ImSimao/FE-AGSG-S2026/schemes/README.md

Electromechanical diagrams
====

This directory contains the electrical schematic diagrams of the vehicle's electromechanical components.

## Files

- `communication_diagram.png` — data and communication links between the controllers, sensors and actuators (UART, I2C, PWM, GPIO).
- `power_diagram.png` — power distribution (battery, regulators, motor, servo, controllers and sensors).
