ImSimao/FE-AGSG-S2026/ui/arena.png

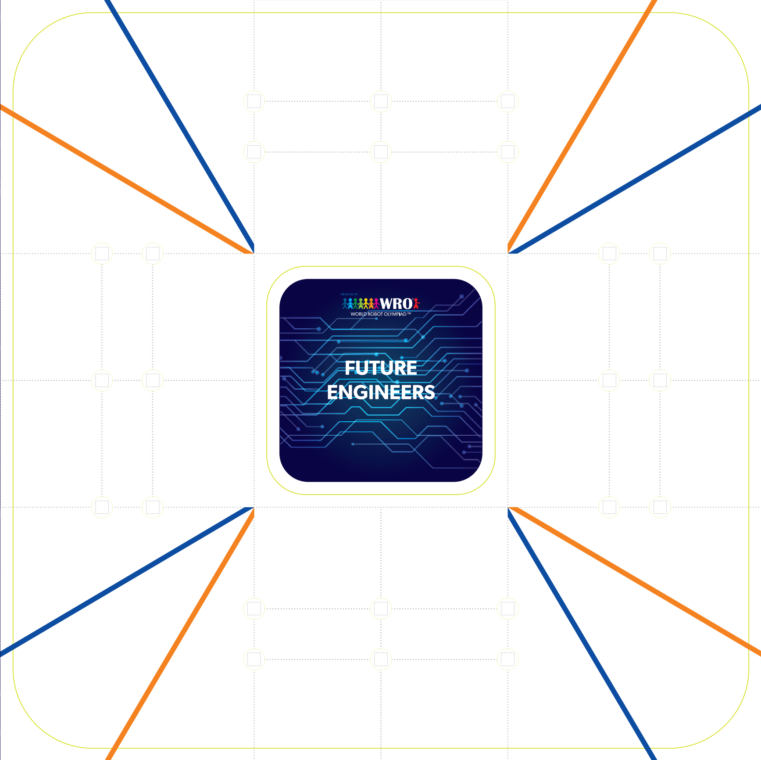
ui/arena.png
