ImSimao/FE-AGSG-S2026/models/Front Bearing.step

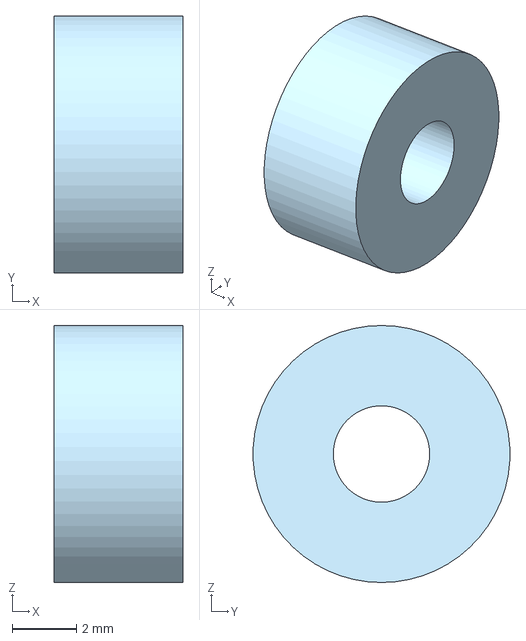
[picture p10: CAD file, 2026-11-11]
models/Front Bearing.step
4.00 x 7.99 x 8.00 mm
