ImSimao/FE-AGSG-S2026/models/Sonar Support.step

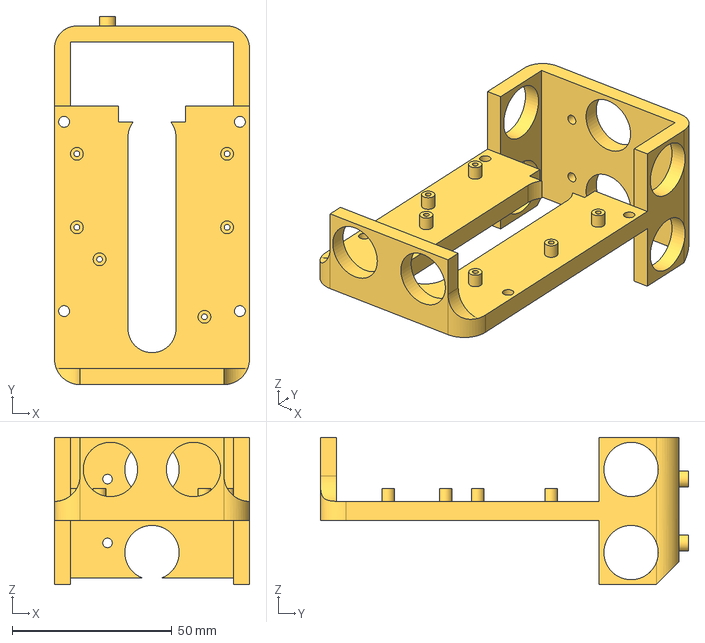
[picture p11: CAD file, 2026-11-11]
models/Sonar Support.step
61.0 x 115.2 x 46.0 mm
