ImSimao/FE-AGSG-S2026/models/Arm v1.step

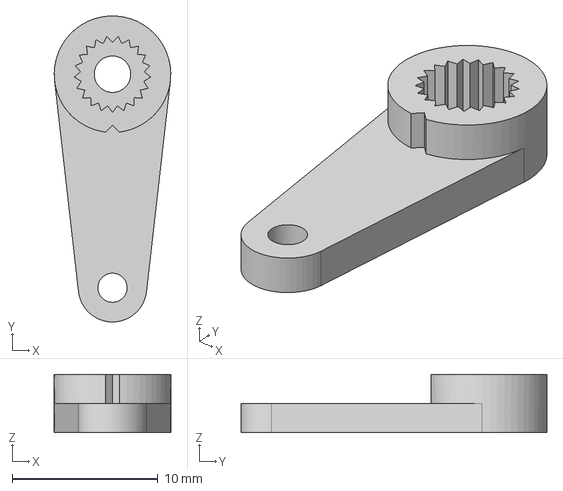
[picture p12: CAD file, 2026-11-11]
models/Arm v1.step
8.00 x 21.0 x 4.00 mm
