ImSimao/FE-AGSG-S2026/models/Wheel Front-Right.step

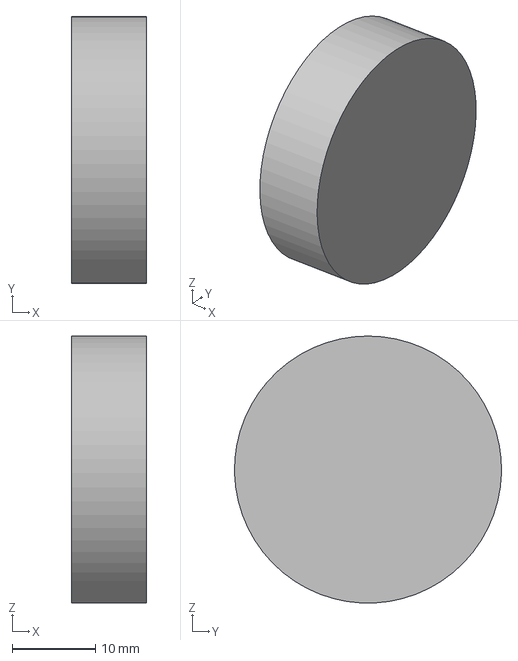
[picture p13: CAD file, 2026-11-11]
models/Wheel Front-Right.step
9.00 x 32.0 x 32.0 mm
