ImSimao/FE-AGSG-S2026/models/Axle Sleeve.step

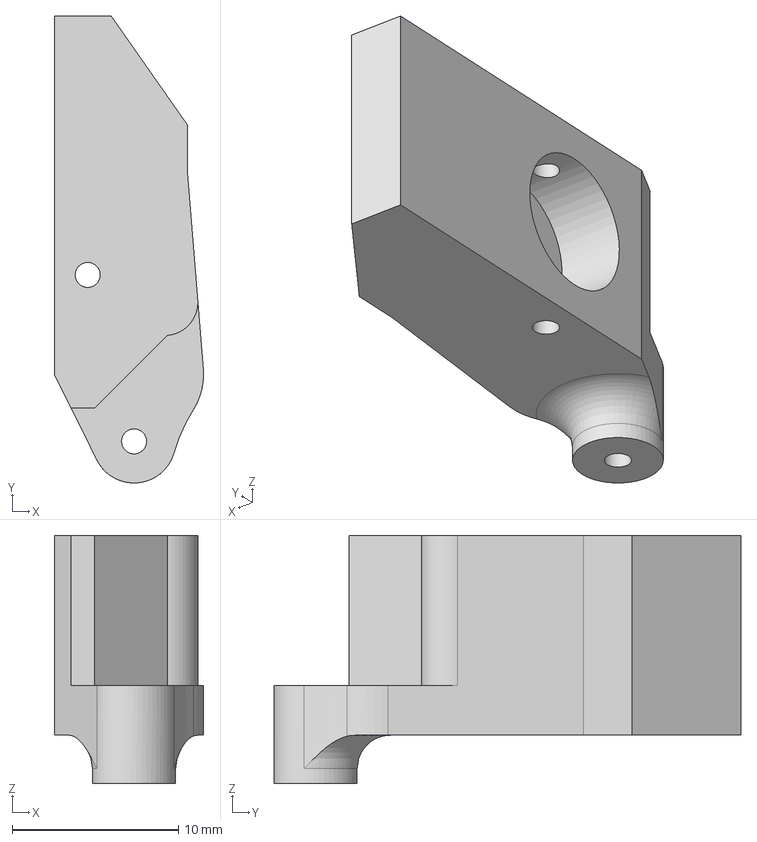
[picture p14: CAD file, 2026-11-11]
models/Axle Sleeve.step
8.96 x 28.1 x 14.9 mm
