ImSimao/FE-AGSG-S2026/models/Servo Support.step

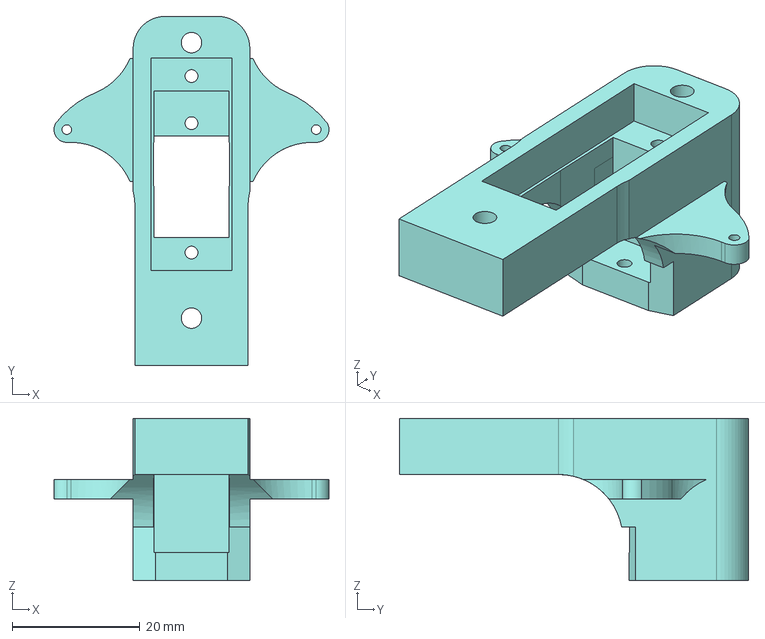
[picture p15: CAD file, 2026-11-11]
models/Servo Support.step
43.0 x 54.6 x 25.4 mm
