ImSimao/FE-AGSG-S2026/models/Gear Housing.step

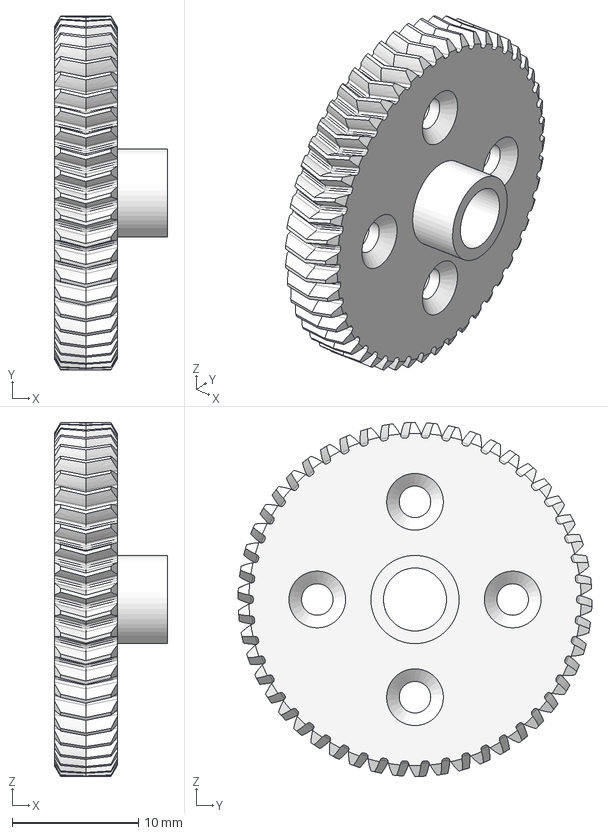
[picture p16: CAD file, 2026-11-11]
models/Gear Housing.step
9.00 x 28.1 x 28.1 mm
