ImSimao/FE-AGSG-S2026/models/Housing.step

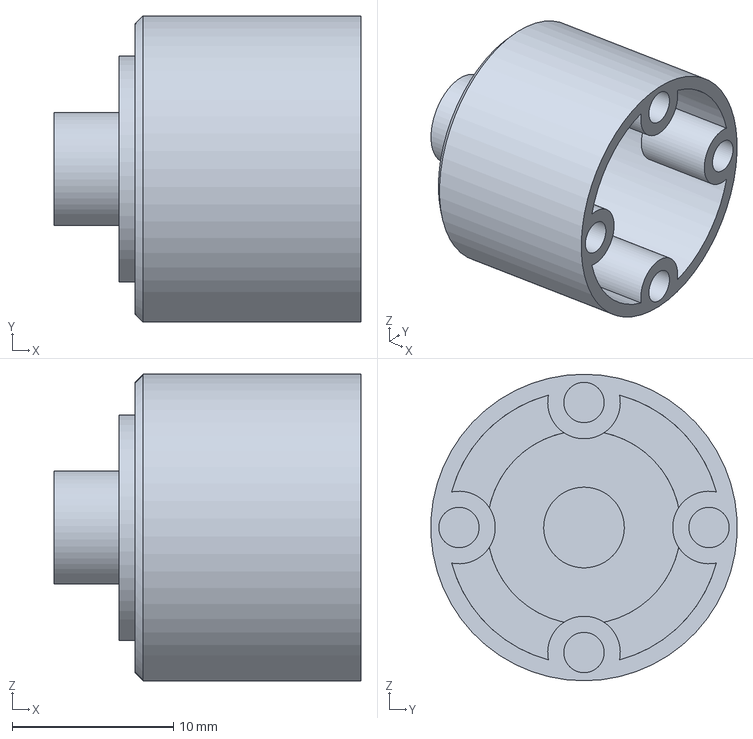
[picture p17: CAD file, 2026-11-11]
models/Housing.step
19.0 x 19.0 x 19.0 mm
