ImSimao/FE-AGSG-S2026/models/Differential Box Top.step

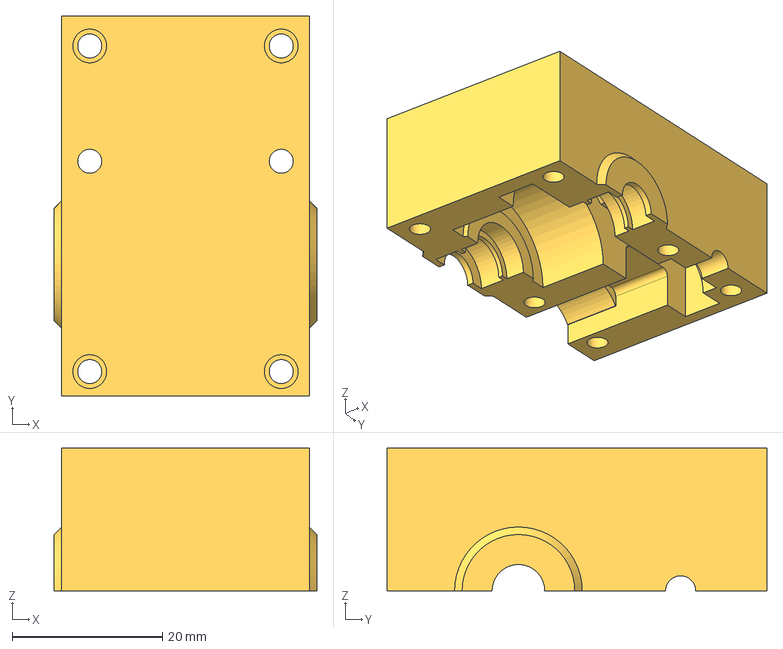
[picture p18: CAD file, 2026-11-11]
models/Differential Box Top.step
35.0 x 50.6 x 19.0 mm
