ImSimao/FE-AGSG-S2026/models/Differential Support.step

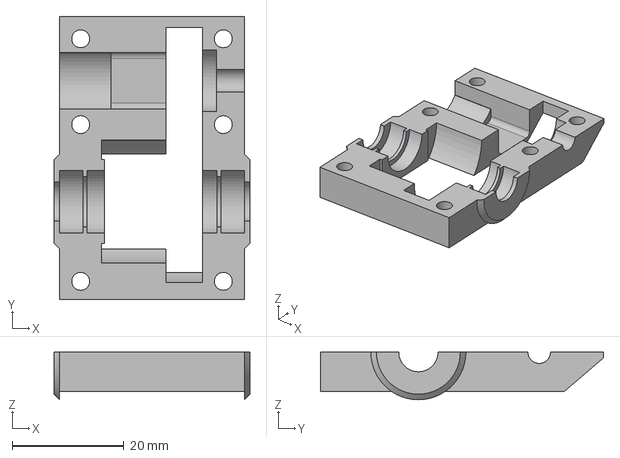
[picture p19: CAD file, 2026-11-11]
models/Differential Support.step
35.0 x 50.6 x 8.50 mm
