ImSimao/FE-AGSG-S2026/models/Base.step

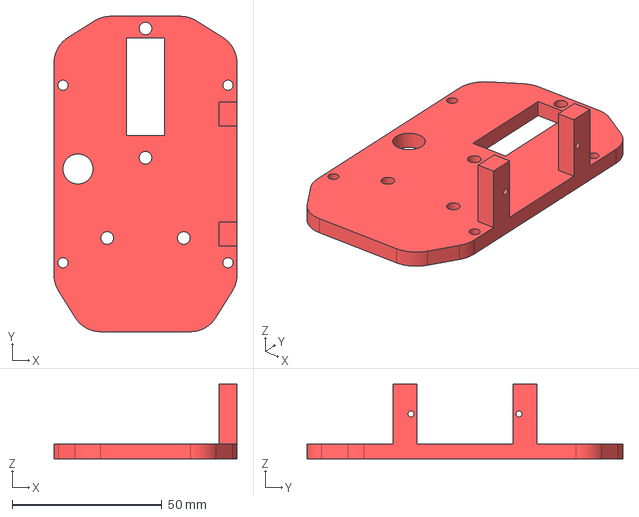
[picture p20: CAD file, 2026-11-11]
models/Base.step
61.0 x 105.2 x 25.0 mm
