ImSimao/FE-AGSG-S2026/models/Motor Gear Bearing.step

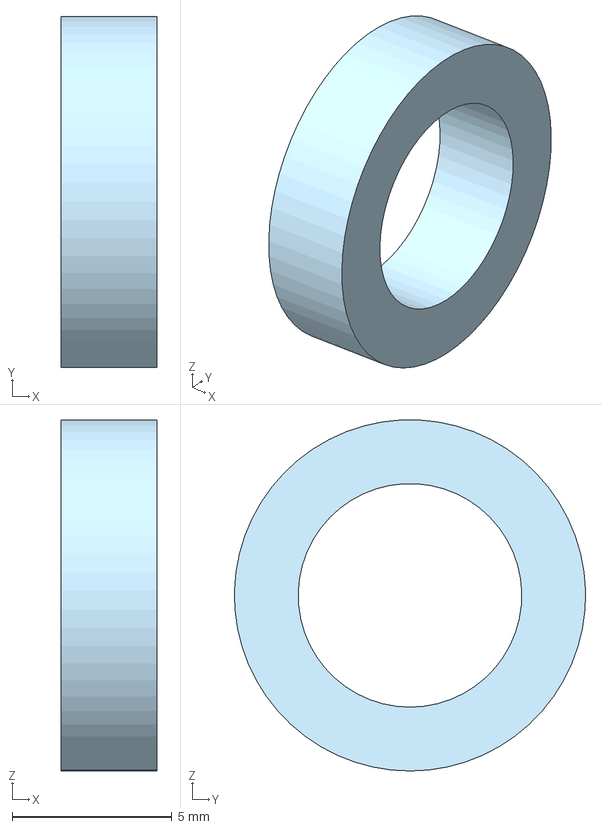
[picture p21: CAD file, 2026-11-11]
models/Motor Gear Bearing.step
3.00 x 11.0 x 11.0 mm
