ImSimao/FE-AGSG-S2026/models/Steering Bar.step

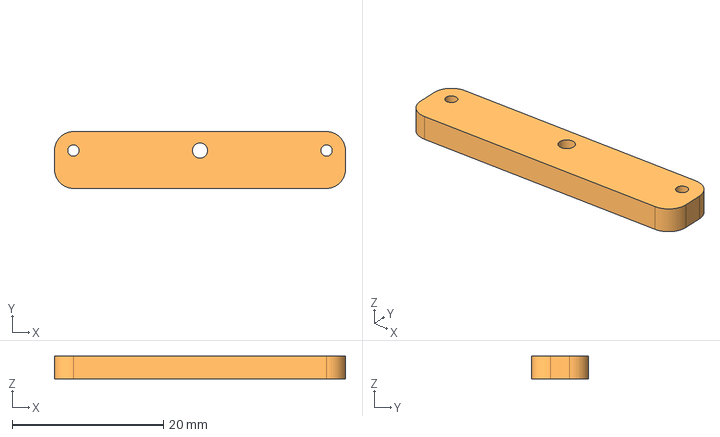
[picture p22: CAD file, 2026-11-11]
models/Steering Bar.step
38.4 x 7.50 x 3.00 mm
