ImSimao/FE-AGSG-S2026/models/Raspberry Pi Base.step

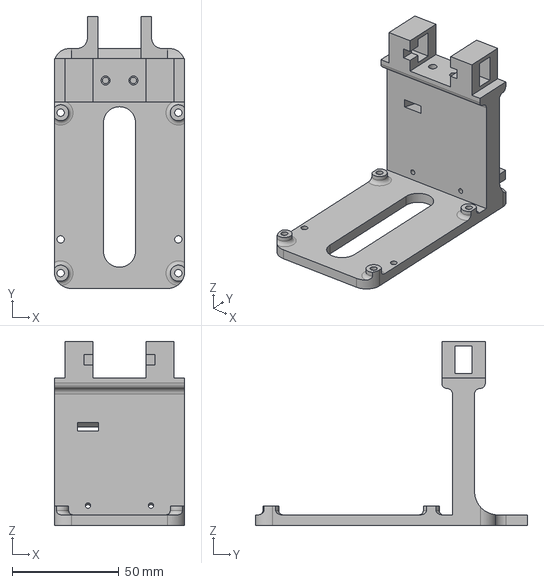
[picture p23: CAD file, 2026-11-11]
models/Raspberry Pi Base.step
61.0 x 127.2 x 86.0 mm
