ImSimao/FE-AGSG-S2026/models/Terminal 2.step

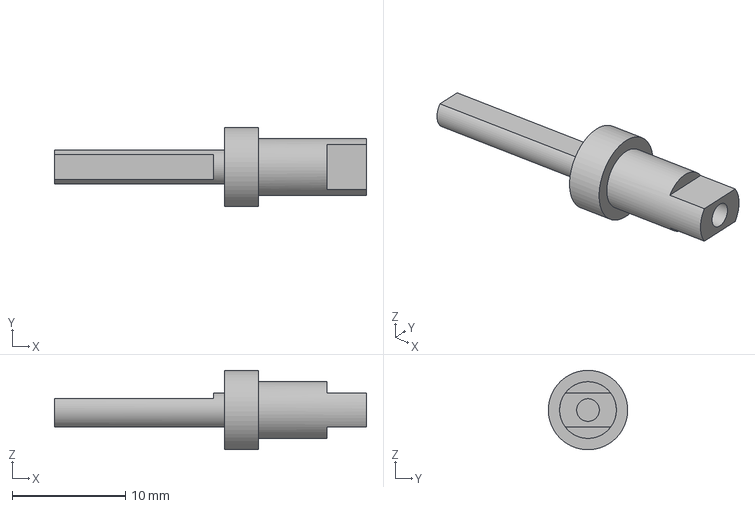
[picture p24: CAD file, 2026-11-11]
models/Terminal 2.step
27.5 x 7.00 x 6.99 mm
