ImSimao/FE-AGSG-S2026/models/Strut.step

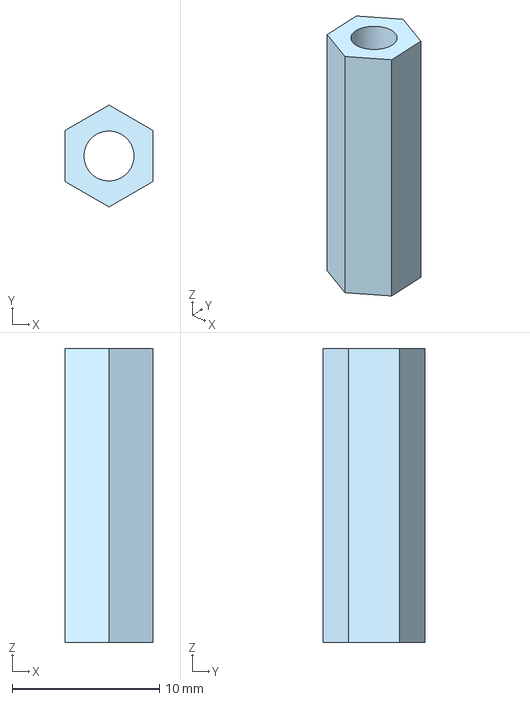
[picture p25: CAD file, 2026-11-11]
models/Strut.step
6.00 x 6.93 x 20.0 mm
