ImSimao/FE-AGSG-S2026/models/Motor Gear.step

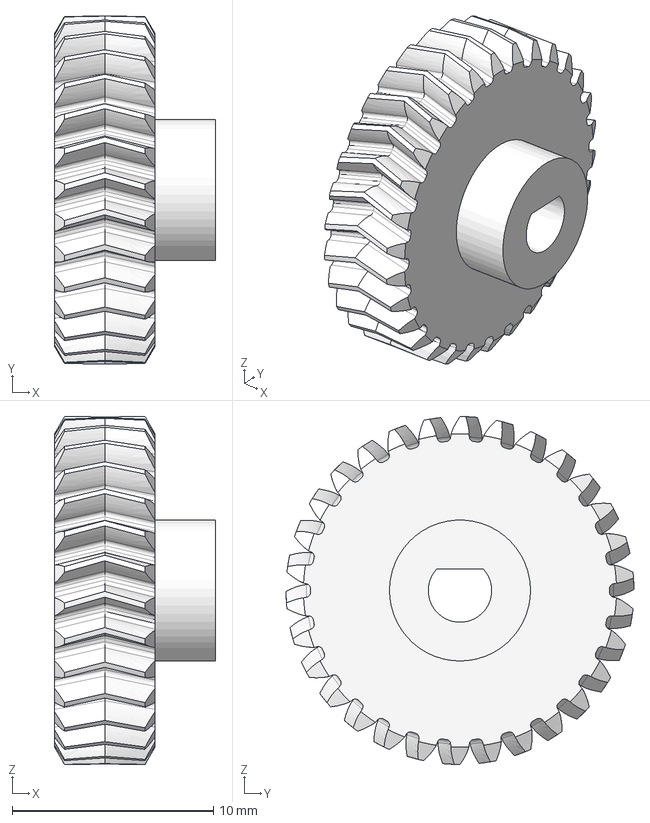
[picture p26: CAD file, 2026-11-11]
models/Motor Gear.step
8.00 x 17.3 x 17.3 mm
