ImSimao/FE-AGSG-S2026/models/MG90S v2.step

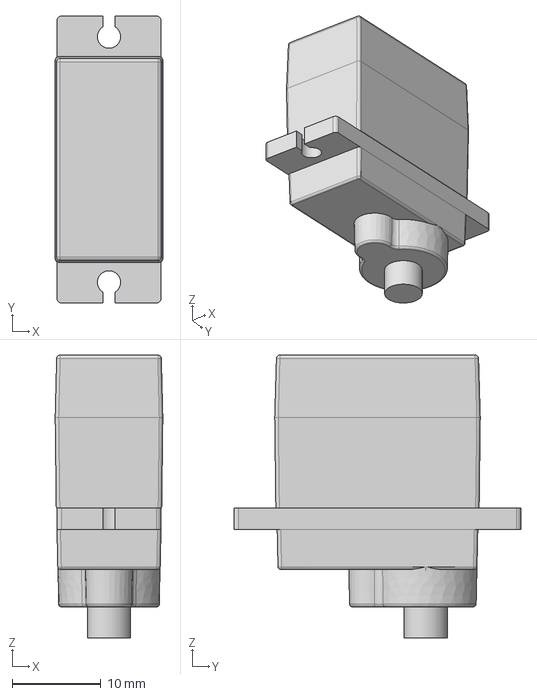
[picture p27: CAD file, 2026-11-11]
models/MG90S v2.step
12.1 x 32.2 x 31.8 mm
