ImSimao/FE-AGSG-S2026/models/Terminal Bearing.step

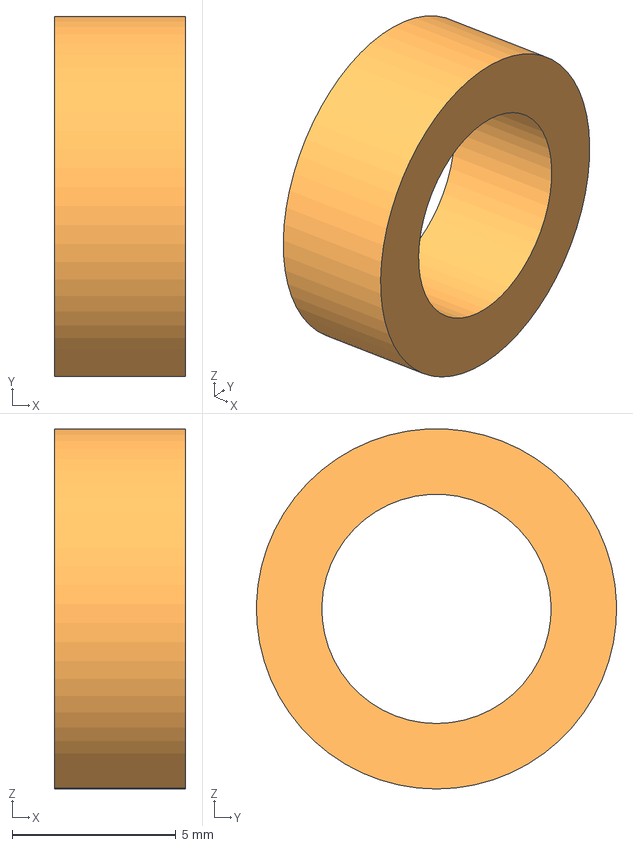
[picture p28: CAD file, 2026-11-11]
models/Terminal Bearing.step
4.00 x 11.0 x 11.0 mm
