ImSimao/FE-AGSG-S2026/(list of files, cad)

Other CAD files:
models/Wheel Rear-Right.step
models/Wheel.step
models/Bearing.step
models/Differential Bearing.step
models/Terminal 1.step
models/Steering Pivot Front-Right.step
models/Arm v1.stl
models/Axle Sleeve.stl
models/Base.stl
models/Bearing.stl
models/Differential Bearing.stl
models/Differential Box Top.stl
models/Differential Support.stl
models/Front Bearing.stl
models/Gear Housing.stl
models/Housing.stl
models/MG90S v2.stl
models/Motor Gear Bearing.stl
models/Motor Gear.stl
models/Old Nose.step
models/Old Nose.stl
models/Old Sonar Base.step
models/Old Sonar Base.stl
models/Raspberry Pi Base.stl
models/Servo Support.stl
models/Sonar Support.stl
models/Steering Bar.stl
models/Steering Pivot Front-Right.stl
models/Strut.stl
models/Terminal 1.stl
models/Terminal 2.stl
models/Terminal Bearing.stl
models/Wheel Front-Right.stl
models/Wheel Rear-Right.stl
models/Wheel.stl
