ImSimao/FE-AGSG-S2026/src/robot/state.py

class State:
    """Static-style container for robot self."""
    outer_wall = 303
    inner_wall = 103

    def __init__(self):
        self.clockwise = 0
        self.current_lane = 0
        self.odom_x = 0.0
        self.odom_y = 0.0
        self.initial_compass_angle = 0.0
        self.compass_angle = 0.0
        self.current_speed = 0.0
        self.raw_speed = 0.0
        self.target_speed = 0.0

    @property
    def relative_lane(self):
        return self.current_lane % 4

    @property
    def is_lane_with_parking(self):
        return self.relative_lane == 0

    @property
    def lap(self):
        return self.current_lane // 4

    @property
    def compass_angle_relative(self):
        return (self.compass_angle + 
        (self.relative_lane * -90.0 * self.clockwise) + 360.0) % 360.0

    def set_relative_odom(self, x_relative, y_relative, check_diff=False, reset_covariance=True):

        if self.relative_lane == 0:
            if self.clockwise == -1:
                self.odom_x = x_relative
                self.odom_y = y_relative
            else:
                self.odom_x = State.outer_wall-x_relative
                self.odom_y = y_relative
        elif self.relative_lane == 1:
            if self.clockwise == -1:
                self.odom_x = State.outer_wall-y_relative
                self.odom_y = x_relative
            else:
                self.odom_x = y_relative
                self.odom_y = x_relative
        elif self.relative_lane == 2:
            if self.clockwise == -1:
                self.odom_x = State.outer_wall-x_relative
                self.odom_y = State.outer_wall-y_relative
            else:
                self.odom_x = x_relative
                self.odom_y = State.outer_wall-y_relative
        elif self.relative_lane == 3:
            if self.clockwise == -1:
                self.odom_x = y_relative
                self.odom_y = State.outer_wall-x_relative
            else:
                self.odom_x = State.outer_wall-y_relative
                self.odom_y = State.outer_wall-x_relative

        # A challenge snap is a new pose, not a sonar residual. Tighten P so
        # the filter does not pull back toward the pre-snap estimate.
        if reset_covariance:
            from ekf import pose_ekf
            pose_ekf.reset_from_state()

    @property
    def get_relative_odom(self):
        if self.relative_lane == 0:
            if self.clockwise == -1:
                return self.odom_x, self.odom_y
            else:
                return State.outer_wall-self.odom_x, self.odom_y
        elif self.relative_lane == 1:
            if self.clockwise == -1:
                return self.odom_y, State.outer_wall-self.odom_x
            else:
                return self.odom_y, self.odom_x
        elif self.relative_lane == 2:
            if self.clockwise == -1:
                return State.outer_wall-self.odom_x, State.outer_wall-self.odom_y
            else:
                return self.odom_x, State.outer_wall-self.odom_y
        elif self.relative_lane == 3:
            if self.clockwise == -1:
                return State.outer_wall-self.odom_y, self.odom_x
            else:
                return State.outer_wall-self.odom_y, State.outer_wall-self.odom_x

state = State()
