ImSimao/FE-AGSG-S2026/src/pid.py

class PIDController:
    def __init__(self, kp, ki, kd, output_min=-40.0, output_max=40.0, integral_limit=30.0):
        self.kp = kp
        self.ki = ki
        self.kd = kd
        self.output_min = output_min
        self.output_max = output_max
        self.integral_limit = integral_limit
        self.integral = 0.0
        self.prev_error = 0.0

    def reset(self):
        self.integral = 0.0
        self.prev_error = 0.0

    def compute(self, error, dt):
        if dt <= 0:
            dt = 0.1

        self.integral += error * dt
        if self.integral > self.integral_limit:
            self.integral = self.integral_limit
        elif self.integral < -self.integral_limit:
            self.integral = -self.integral_limit

        derivative = (error - self.prev_error) / dt
        output = (self.kp * error) + (self.ki * self.integral) + (self.kd * derivative)
        self.prev_error = error

        if output > self.output_max:
            return self.output_max
        if output < self.output_min:
            return self.output_min
        return output
