ImSimao/FE-AGSG-S2026/src/robot/background.py

from distance import Distance
from camera import Camera
import time
import math
from compass import Compass
from encoder import Encoder
from motor import Motor
from servo import Servo
from state import state
from telemetry import Telemetry
from ekf import pose_ekf


SENSOR_INTERVAL_MS    = 20    # 50 Hz
CAMERA_INTERVAL_MS    = 20    # 50 Hz (matches the ~30-60 FPS camera frame rate)
ODOM_INTERVAL_MS      = 10    # 100 Hz
SPEED_INTERVAL_MS     = 100   # 10 Hz
TELEMETRY_INTERVAL_MS = 50    # 20 Hz
EKF_LOG_INTERVAL_MS   = 500   # pose-filter trace, plain-text log only
ADJUST_ODOM_INTERVAL_MS = 25  # 40 Hz
LOOP_SLEEP_MS = 1

# How long to hold the brake when the requested direction is opposite to the
# current motion, so the wheels really stop before the motor reverses.
REVERSE_HOLD_MS = 500



class CruiseControl:
    """Incremental proportional controller with acceleration/deceleration limits."""

    def __init__(self, kp=1/150, max_accel=0.35, max_decel=1.125, min_drive_pwm=0.15):
        self.kp = kp
        self.max_accel = max_accel   # max PWM increase per second
        self.max_decel = max_decel   # max PWM decrease per second
        self.min_drive_pwm = min_drive_pwm  # min PWM that overcomes motor friction
        self.current_pwm = 0.0
        self._reverse_hold_until = 0  # ticks_ms deadline of the reversal hold

    def update(self, dt):
        # Target stopped: brake so the robot stops at the target instead of
        # coasting past it (the motor cannot creep below ~10 cm/s).
        if state.target_speed == 0:
            self.current_pwm = 0.0
            self._reverse_hold_until = 0
            Motor.brake()
            return

        # Direction change: hold the brake for REVERSE_HOLD_MS so the wheels
        # really stop before the motor reverses. Reversing while still rolling
        # makes them skid (the encoder counts wheel spin that does not
        # translate into travel) and corrupts the odometry.
        now = time.ticks_ms()
        if self._reverse_hold_until == 0:
            if state.target_speed * state.raw_speed < 0:
                self._reverse_hold_until = now + REVERSE_HOLD_MS
        if self._reverse_hold_until != 0:
            if time.ticks_diff(now, self._reverse_hold_until) < 0:
                self.current_pwm = 0.0
                Motor.brake()
                return
            self._reverse_hold_until = 0

        error = state.target_speed - state.current_speed
        desired_pwm = self.current_pwm + self.kp * error

        # Clamp the desired PWM to the valid range
        if desired_pwm > 1.0:
            desired_pwm = 1.0
        elif desired_pwm < -1.0:
            desired_pwm = -1.0

        # Keep the motor turning: below a small PWM static friction stops it.
        # Apply the floor to the DESIRED pwm (not to current_pwm) so the
        # acceleration rate limit still applies: otherwise the PWM jumps to the
        # floor in one cycle and the robot jerks (and skids while turning).
        if state.target_speed > 0 and desired_pwm < self.min_drive_pwm:
            desired_pwm = self.min_drive_pwm

        # Rate-limit the change (acceleration / deceleration). A sharp steering
        # angle needs less torque or the wheels scrub, so the rate is scaled:
        # full when the servo is straight, 0.65 when it is fully steered.
        steering = abs(Servo.current_angle) / float(Servo._MAX_STEERING_OFFSET)
        if steering > 1.0:
            steering = 1.0
        accel_scale = 1.0 - 0.35 * steering

        delta = desired_pwm - self.current_pwm

        if (abs(state.current_speed) < 3.0 and
                abs(self.current_pwm) < 0.30):
            # Starting from rest: climb quickly through the low-PWM region where
            # the motor only creeps (5-15 cm/s), so each start does not feel
            # like the robot is still stopped. Above it, the normal ramp applies.
            max_delta = self.max_accel * 4.0 * accel_scale * dt
        elif delta > 0:
            max_delta = self.max_accel * accel_scale * dt
        else:
            max_delta = self.max_decel * accel_scale * dt

        if delta > max_delta:
            delta = max_delta
        elif delta < -max_delta:
            delta = -max_delta

        self.current_pwm += delta

        if self.current_pwm > 1.0:
            self.current_pwm = 1.0
        elif self.current_pwm < -1.0:
            self.current_pwm = -1.0

        # Motor output: positive PWM drives forward, negative PWM applies
        # reverse torque (mild braking). This slows the robot down without
        # stopping it completely (which would need extra torque to restart).
        if self.current_pwm > 0:
            Motor.forward()
            Motor.ena.duty_u16(int(self.current_pwm * 65535))
        else:
            Motor.backward()
            Motor.ena.duty_u16(int(-self.current_pwm * 65535))


cruiseControl = CruiseControl()

def _read_distance_sensors():
    Distance.get_sensor_data()

def _read_camera():
    Camera.update()

def _adjust_odometry():
    if state.clockwise == 0:
        return

    correct_corridor()
    correct_corner()

def _fmt_innov(value):
    if value is None:
        return "none"
    return "%.2f" % value


def update_odom(x_relative, y_relative, observe_x=True, observe_y=True):
    # Geometric gates in the callers decide that this wall reading is meaningful.
    # The filter accepts each observed axis on its own Mahalanobis gate.
    prev_x, prev_y = state.get_relative_odom
    innov_x, innov_y, accepted_x, accepted_y = pose_ekf.update_relative(
        x_relative, y_relative, observe_x, observe_y
    )
    curr_x, curr_y = state.get_relative_odom
    Telemetry.log(
        "ekf odom %.1f,%.1f -> %.1f,%.1f z=(%.1f,%.1f) obs=(%d,%d) innov=(%s,%s) accept=(%d,%d) trace=%.2f"
        % (
            prev_x, prev_y, curr_x, curr_y,
            x_relative, y_relative,
            1 if observe_x else 0, 1 if observe_y else 0,
            _fmt_innov(innov_x), _fmt_innov(innov_y),
            1 if accepted_x else 0, 1 if accepted_y else 0,
            pose_ekf.trace(),
        )
    )

def correct_corner():
    curr_x, curr_y = state.get_relative_odom

    if curr_x > 90 and curr_y > 90:
            return

    angle = state.compass_angle_relative

    if angle > 180:
        angle -= 360
    
    if abs(90 + angle * state.clockwise) < 10 or abs(-90 + angle * state.clockwise) < 10:

        #Entered corner from inside
        if curr_x > 60 and curr_y > 40:
            return

        if curr_x < 25:
            return

        distance_left, distance_right, distance_front, distance_rear = get_odom_side_sonar()


        if distance_front > 55 or distance_front <= 3:
            return

        if state.clockwise == 1:
            if distance_left > 80 or distance_left <= 3:
                return

            update_odom(distance_left, distance_front)
        else:
            if distance_right > 80 or distance_right <= 3:
                return

            update_odom(distance_right, distance_front)



        if abs(angle * state.clockwise) < 10:

            distance_left, distance_right, distance_front, distance_rear = get_odom_side_sonar()


            if distance_rear > 55 or distance_rear <= 3:
                return

             #Entered corner from inside
            if curr_x > 60 and curr_y > 40:
                update_odom(distance_rear, curr_y, observe_y=False)
                return


            if state.clockwise == 1:
                if distance_left > 50 or distance_left <= 3:
                    return

                update_odom(distance_rear, distance_left)
            else:
                if distance_right > 50 or distance_right <= 3:
                    return

                update_odom(distance_rear, distance_right)


def correct_corridor():
    curr_x, curr_y = state.get_relative_odom

    distance_left, distance_right, distance_front, distance_rear = get_odom_side_sonar()

    angle = state.compass_angle_relative

    if angle > 180:
        angle -= 360


    if abs(state.compass_angle_relative) > 10:
        return

    #if curr_y > 50:    
    if curr_x < 100 or curr_x > 180:
        return
        
    #if curr_y < 5 or curr_y > 95:
    #    return

    if state.is_lane_with_parking:
        if curr_y < 62:
            if state.clockwise == 1 and curr_x < 145:
                return
            if state.clockwise == -1 and curr_x > 155:
                return
            

    if curr_y < 50 and state.clockwise == 1 or curr_y > 50 and state.clockwise == -1:
        if distance_left > 50 or distance_left <= 3:
            return

        offset = distance_left


        update_odom(state.get_relative_odom[0], abs((100 if curr_y > 50 else 0) - offset), observe_x=False)
    else:
        if distance_right > 50 or distance_right <= 3:
            return

        offset = distance_right

        update_odom(state.get_relative_odom[0], abs((100 if curr_y > 50 else 0) - offset), observe_x=False)

def get_abs_distance(sonar_offset, angle, distance, is_side = False):

    hipotenusa = math.sqrt(sonar_offset[0]**2 + (sonar_offset[1]+distance)**2) if is_side else distance + sonar_offset[0]

    angle1 =  math.radians(90 - angle) - (math.atan2(sonar_offset[1]+distance, sonar_offset[0]) if is_side else 0)
    
    y = hipotenusa * math.cos(angle1)


    return y

def get_odom_side_sonar():
    sonar_interval = 1/10
    distance_delta = sonar_interval * state.current_speed
    side_sonar_offset = (7.97, 2.55)
    front_sonar_offset = (8.97, 0)
    rear_sonar_offset = (1.25, 0)

    angle = state.compass_angle_relative

    while angle > 45:
        angle -= 90

    while angle < -45:
        angle += 90

    angle_rad = math.radians(angle)
    side_distance_backtrack = math.tan(angle_rad) * distance_delta


    is_positive_angle = angle > 0

    if not is_positive_angle:
        side_distance_backtrack = -side_distance_backtrack

    distance_left = get_abs_distance(side_sonar_offset, -angle, Distance.get_left() + side_distance_backtrack, True)
    distance_right = get_abs_distance(side_sonar_offset, angle, Distance.get_right() - side_distance_backtrack, True)
    distance_front = get_abs_distance(front_sonar_offset, 90-angle, Distance.get_front() - distance_delta)
    distance_rear = get_abs_distance(rear_sonar_offset, 90+angle, Distance.get_rear() + distance_delta)

    return distance_left, distance_right, distance_front, distance_rear


def _update_odometry(last_distance_cm):
    compass_angle = Compass.heading()
    state.compass_angle = compass_angle

    current_distance_cm = Encoder.distance_cm()
    delta_cm = current_distance_cm - last_distance_cm
    theta_rad = math.radians(compass_angle)
    pose_ekf.predict(delta_cm, theta_rad)

    return current_distance_cm


def update_speed(last_distance_cm, last_speed_ms):
    current_distance_cm = Encoder.distance_cm()
    delta_cm = current_distance_cm - last_distance_cm
    delta_time_ms = time.ticks_diff(time.ticks_ms(), last_speed_ms)
    delta_time_s = delta_time_ms / 1000.0

    if delta_time_ms <= 0:
        return current_distance_cm

    raw_speed = delta_cm / delta_time_s
    state.raw_speed = raw_speed
    # Low-pass filter so the controller does not chase encoder noise / cogging.
    state.current_speed = state.current_speed + 0.5 * (raw_speed - state.current_speed)

    cruiseControl.update(delta_time_s)

    return current_distance_cm

def _send_telemetry():
    """Transmit current pose and distance sensor readings."""
    Telemetry.send()


def background_task():
    last_distance_cm = Encoder.distance_cm()
    last_speed_cm = last_distance_cm
    last_sensor_ms = time.ticks_ms()
    last_camera_ms = last_sensor_ms
    last_odom_ms = last_sensor_ms
    last_speed_ms = last_sensor_ms
    last_telemetry_ms = last_sensor_ms
    last_ekf_log_ms = last_sensor_ms
    last_adjust_odom_ms = last_sensor_ms

    print("Background task started")

    while True:
        now_ms = time.ticks_ms()
        if time.ticks_diff(now_ms, last_sensor_ms) >= SENSOR_INTERVAL_MS:
            _read_distance_sensors()
            last_sensor_ms = now_ms

        now_ms = time.ticks_ms()
        if time.ticks_diff(now_ms, last_camera_ms) >= CAMERA_INTERVAL_MS:
            _read_camera()
            last_camera_ms = now_ms

        now_ms = time.ticks_ms()
        if time.ticks_diff(now_ms, last_odom_ms) >= ODOM_INTERVAL_MS:
            last_distance_cm = _update_odometry(last_distance_cm)
            last_odom_ms = now_ms

        now_ms = time.ticks_ms()
        if time.ticks_diff(now_ms, last_speed_ms) >= SPEED_INTERVAL_MS:
            last_speed_cm = update_speed(last_speed_cm, last_speed_ms)
            last_speed_ms = now_ms

        now_ms = time.ticks_ms()
        if time.ticks_diff(now_ms, last_telemetry_ms) >= TELEMETRY_INTERVAL_MS:
            _send_telemetry()
            last_telemetry_ms = now_ms

        now_ms = time.ticks_ms()
        if time.ticks_diff(now_ms, last_ekf_log_ms) >= EKF_LOG_INTERVAL_MS:
            Telemetry.log_ekf(pose_ekf.trace(), pose_ekf.last_innov_x, pose_ekf.last_innov_y)
            last_ekf_log_ms = now_ms

        now_ms = time.ticks_ms()
        if time.ticks_diff(now_ms, last_adjust_odom_ms) >= ADJUST_ODOM_INTERVAL_MS:
            _adjust_odometry()
            last_adjust_odom_ms = now_ms

        time.sleep_ms(LOOP_SLEEP_MS)
        
