ImSimao/FE-AGSG-S2026/src/obstacle_challenge.py

import time
from background import get_odom_side_sonar
from field import Field, Lane
from  move_coordinates import move_coordinates, rotate_angle, rotate_coordinates
from distance import Distance
from state import State, state
from telemetry import Telemetry

#Coordinates




ninety_degrees_distance_offset =18 # 16.5

traffic_lane_center = (state.outer_wall - state.inner_wall) / 4
traffic_lane_y_offset = 30 #26.25
traffic_lane_y_parking = 11.5
firt_obstacle_camera_coord = (100, traffic_lane_center)
second_obstacle_camera_coord = (200, traffic_lane_center)
first_traffic_lane_camera_x = 150
final_traffic_lane_x = state.outer_wall - traffic_lane_center - traffic_lane_y_offset
parking_x_offset = 5
parking_gap = 45
parking_y = 29


def get_traffic_lane_y(traffic_side, rotate = False, reverse = False):
        return traffic_lane_center \
        + ((traffic_lane_y_offset * -traffic_side) if not state.is_lane_with_parking or traffic_side == -1 \
            else - traffic_lane_y_parking ) \
             - (ninety_degrees_distance_offset * -traffic_side if rotate else 0)
 



def obstacle_challenge():
    global first_traffic_lane_camera_x
    time.sleep(1)

    if Distance.get_left() < Distance.get_right() and (Distance.get_left() > 0 or Distance.get_right() <= 0):
        state.clockwise = 1
    else:
        state.clockwise = -1

    distance_left, distance_right, distance_front, distance_rear = get_odom_side_sonar()

    if state.clockwise == 1:
        state.set_relative_odom(100+1.75, distance_left)
        rotate_coordinates(200, 100)
        time.sleep(1)
    else:
        state.set_relative_odom(200-distance_front, distance_right)
        rotate_coordinates(200, 60)
        time.sleep(1)

    if not Field.parking_traffic_exit_confirmation():
        a=0
        #search for colour
        print("Not detected") 

    if Field.lanes_sides()[1] == -1:
        move_coordinates(state.get_relative_odom[0], get_traffic_lane_y(Field.lanes_sides()[1], True))
    else:
        rotate_angle(65*state.clockwise)
    
    rotate_angle(0)
    move_coordinates((State.inner_wall/2) + (State.outer_wall/2), get_traffic_lane_y(Field.lanes_sides()[1]), rotate = False)
    Field.exiting_park = False
    
    laps = 3

    while state.lap <= laps:
        state.current_lane += 1

    
        if not Field.can_enter_lane():
            #search for colour
            if state.is_lane_with_parking:
                move_coordinates(50, 45)
            else:
                move_coordinates(50, 35)
            
            rotate_angle(0, reverse=True)
                
            rotate_coordinates(firt_obstacle_camera_coord[0], firt_obstacle_camera_coord[1] if not state.is_lane_with_parking else 60)
            
            # Search forward in one continuous move and stop as soon as the
            # camera detects the lane opening (no more 10 cm hops with a stop
            # between each one).
            if state.get_relative_odom[0] <= 100:
                move_coordinates(110, 50 if not state.is_lane_with_parking else 60,
                                 rotate=False, stop_when=Field.can_enter_lane)
            
            rotate_angle(-90*Field.lanes_sides()[0]*state.clockwise, True)
            move_coordinates(state.get_relative_odom[0], get_traffic_lane_y(Field.lanes_sides()[0], True), rotate=False)

        elif Field.lanes_sides()[0] == 1:
            move_coordinates(state.get_relative_odom[0], get_traffic_lane_y(Field.lanes_sides()[0], True), rotate=False)

        elif Field.lanes_sides()[0] == -1:
            if state.get_relative_odom[0] > 50:
                move_coordinates(state.get_relative_odom[0], 65, rotate=False)
                rotate_angle(0, reverse=True)
    
    
        rotate_angle(0)
        
        if state.lap == laps:
            if state.clockwise == 1:
                first_traffic_lane_camera_x = 95
            else:
                first_traffic_lane_camera_x = 175

        if not (Field.can_exit_lane() and Field.lanes_sides()[0] == Field.lanes_sides()[1]) or state.lap == laps:
            move_coordinates(first_traffic_lane_camera_x, get_traffic_lane_y(Field.lanes_sides()[0]), rotate = False)

            if state.lap == laps:
                break

            if not Field.can_exit_lane():
                rotate_coordinates(second_obstacle_camera_coord[0], second_obstacle_camera_coord[1])
                
                start_time = time.ticks_ms()
                while not Field.can_exit_lane():
                    time.sleep(0.1)

                    if time.ticks_ms() - start_time > 3000:
                        break

                sides = Field.lanes_sides()
                if sides[0] == sides[1]:
                    rotate_angle(0, reverse=True)
            
            if Field.lanes_sides()[1] == -1 and state.get_relative_odom[1] < 50 or Field.lanes_sides()[1] == 1 and state.get_relative_odom[1] > 50:
                rotate_angle(-90*Field.lanes_sides()[1]*state.clockwise)
                move_coordinates(state.get_relative_odom[0], get_traffic_lane_y(Field.lanes_sides()[1], reverse=True, rotate=False))
                rotate_angle(0)

        move_coordinates((State.inner_wall/2) + (State.outer_wall/2), get_traffic_lane_y(Field.lanes_sides()[1]), rotate = False)


    #parking      
    move_coordinates((100 + parking_x_offset) if state.clockwise == 1 else 200 - parking_gap + parking_x_offset, state.get_relative_odom[1], rotate = False)
    
    rotate_angle(-90 * state.clockwise)
    
    if state.get_relative_odom[1] > 50:
        move_coordinates(state.get_relative_odom[0], parking_y, rotate=False)
        rotate_angle(-90 * state.clockwise)

    time.sleep(1)

    parking_start_ms = time.ticks_ms()
    while True:
        if time.ticks_diff(time.ticks_ms(), parking_start_ms) > 10000:
            state.target_speed = 0
            break

        diff_distance = Distance.get_front() - 18

        if abs(diff_distance) < 1:
            state.target_speed = 0

            if Distance.get_left() < 30 and Distance.get_right() < 30:
                if Distance.get_left() < Distance.get_right():
                    rotate_angle(-90 * state.clockwise + 25, reverse=True)
                else:
                    rotate_angle(-90 * state.clockwise - 25, reverse=True)
                rotate_angle(-90 * state.clockwise, reverse=True)
                time.sleep(0.5)
            else:
                break

        if diff_distance > 0:
            state.target_speed = 10
        else:
            state.target_speed = -10

        time.sleep(0.05)

    time.sleep(1)

    if Distance.get_left() < Distance.get_right():
        rotate_angle(0 if state.clockwise == 1 else 180)
    else:
        rotate_angle(0 if state.clockwise == -1 else 180)

    rotate_angle(0 if abs(state.compass_angle_relative - 180) > 90 else 180, reverse=True)

    parking_start_ms = time.ticks_ms()
    while True:
        if time.ticks_diff(time.ticks_ms(), parking_start_ms) > 5000:
            state.target_speed = 0
            break

        diff_distance = Distance.get_rear() - 7.5

        if abs(diff_distance) < 1:
            state.target_speed = 0
            break

        if diff_distance > 0:
            state.target_speed = -10
        else:
            state.target_speed = 10

        time.sleep(0.05)
        
    rotate_angle(0 if abs(state.compass_angle_relative - 180) > 90 else 180)

    time.sleep(1)
    Telemetry.log(state.compass_angle_relative)
