ImSimao/FE-AGSG-S2026/(commit log)

2026-03-04 Add BNO08X driver and initial hardware modules
    Vendor an initial BNO08X MicroPython IMU driver and add the first
    implementations of the UART, compass, distance, encoder, motor and servo
    modules.
2026-03-18 Add background task for sensor reading and odometry updates, refactor compass heading method, and implement coordinate movement functionality.
2026-03-18 Add PID controller for improved movement accuracy, refactor coordinate rotation logic, and update servo steering limits. Introduce time-based control in movement functions.
2026-03-18 Add speed control functionality with PID controller, update motor control methods, and integrate speed updates in the background task. Enhance state management for current and target speeds.
2026-03-25 Refactor speed control by replacing PID controller with a new CruiseControl class, enhancing PWM management and acceleration limits. Update motor control logic in move_coordinates.py to set target sp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
2026-03-25 Implement telemetry functionality for pose and distance data transmission over UART. Update background task to include telemetry sending at regular intervals. Adjust speed control parameters in move_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
2026-04-01 Refactor move_coordinates.py to use relative compass angle for rotation calculations, improve servo angle handling, and adjust time step for smoother movement. Update state management for odometry an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
2026-04-08 Update background and move_coordinates modules to improve timing intervals and streamline odometry access. Refactor state management to utilize a single method for relative odometry retrieval, enhanc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
2026-04-08 Refactor background, move_coordinates, state, and telemetry modules to enhance odometry calculations and improve compass angle handling. Adjust timing intervals for sensor updates and streamline serv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
2026-04-15 Refactor init and main modules to adjust frequency settings and integrate obstacle challenge logic. Enhance move_coordinates functionality with reverse movement capabilities and improve rotation area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
    [init.py, main.py, move_coordinates.py, obstacle_challenge.py, state.py]
2026-04-15 Refactor obstacle_challenge.py to enhance traffic lane navigation logic and integrate new coordinate calculations. Update move_coordinates.py to comment out unused return statement for improved flow.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
2026-04-29 Add periodic sonar-based odometry correction
    Run corrigir_corredor() and corrigir_canto() at 1 Hz from the background
    task to realign odometry with the side and front sonar readings inside the
    corridor and parking lane. Also add the parede_fora/parede_dentro track
    constants, retune the servo centre and steering offset, and derive the
    traffic-lane geometry from those constants.
    [background.py, main.py, move_coordinates.py, obstacle_challenge.py, servo.py, state.py]
2026-05-06 Correct sonar distances for robot pose before odometry fixes
    Add get_odom_side_sonar() to convert the side, front and rear sonar
    readings into absolute track distances, compensating for the mounting
    offset, the current heading and the distance travelled since the last
    sample, and use it in the odometry corrections and the challenge start.
    [background.py, obstacle_challenge.py]
2026-05-06 Tighten odometry tolerances and rework parking approach
    Only apply the odometry corrections within 5 degrees of the target
    heading, and rework the parking geometry to use an offset plus gap from
    the inner wall instead of fixed coordinates.
    [background.py, obstacle_challenge.py]
2026-06-12 Raise rotation and cruising speeds
    Increase the rotation target speed to 15 and the cruising speed range to
    15-60 in move_coordinates(), and add an intermediate waypoint before the
    first camera alignment.
2026-06-12 Add camera firmware for traffic signal detection
    Add the OpenMV firmware that finds the largest red or green blob and
    reports its colour and horizontal position to the robot over four GPIO
    pins (P0-P3), with a debug drawing/ROI mode.
2026-06-12 Add camera field-of-view mapping for traffic signals
    Add camera.py with the camera mounting constants and helpers that work
    out which traffic lights should currently be inside the camera's field of
    view from the estimated pose and heading.
2026-06-12 Refine camera blob filtering and region of interest
    Run the camera at QQVGA with a region of interest covering the bottom
    63% of the frame, filter blobs on their height/width ratio, and reindent
    the firmware with spaces.
2026-06-12 Update camera parameters for improved positioning and adjust debug settings in main.py. Increase camera distance and robot distance from camera for better accuracy. Disable debug mode for production 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
2026-06-12 Add camera integration and field management for traffic signals
    - Introduced Camera class for handling traffic-light detections from the OpenMV camera.
    - Updated background task to read camera data at 200 Hz.
    - Created Field and Lane classes to manage traffic signals and lane states.
    - Enhanced get_colour_position function to utilize new lane structure.
    - Initialized camera in the main application for real-time signal processing.
2026-06-12 Drive lane logic from the traffic signal field model
    Base the obstacle challenge lane choices on the Field/Lane model
    (lanes_sides, can_enter_lane, can_exit_lane) instead of a hardcoded
    traffic_inside flag, report lane sides as -1 for red and 1 for green,
    widen the lane zone checks, add the parking exit confirmation check, and
    return per-light dicts from the camera POV helper.
2026-06-12 Fix camera POV matching and add camera debug script
    Fix the misspelled sine call and the dictionary keys in camera.py, reduce
    the POV camera distance to 70 cm with a 55 cm cutoff and a wider angle
    tolerance, enable the firmware debug view, and add debug_camera.py to
    print blobs, lights in view and zone state on the board. This commit also
    adds __pycache__/camera.cpython-314.pyc, which was committed by accident.
    [camera.py, debug_camera.py, field.py, main.py, obstacle_challenge.py]
2026-06-17 Update camera distance and enhance signal logging
    - Increased camera distance from 70 to 90 for improved detection range.
    - Added telemetry logging for signal setting in Lane class to track signal changes.
    - Adjusted obstacle challenge parameters for better lane entry handling and increased lap count.
2026-06-17 Increase intermediate lane waypoint offset to 35 cm
2026-06-17 Add POV time accumulation and enhance lane management
    - Introduced accumulation of point-of-view (POV) time in the Camera class to track time spent in traffic lanes.
    - Updated Field class to manage POV time for zones, improving lane entry decision-making.
    - Enhanced the can_enter_zone method to consider effective emptiness based on accumulated POV time.
2026-06-24 Update distance thresholds and speed limits for improved navigation
    - Increased angle tolerance in corrigir_canto and corrigir_corredor functions for better maneuvering.
    - Adjusted distance thresholds for sonar readings to enhance obstacle detection.
    - Modified maximum speed in move_coordinates function to optimize movement control.
    - Updated obstacle challenge logic to ensure consistent behavior during lane entry and navigation.
    [background.py, init.py, move_coordinates.py, obstacle_challenge.py]
2026-06-24 Refactor Camera class to incorporate traffic lane positions
    - Updated get_colour_position function to accept possible traffic positions for improved signal handling.
    - Modified _accumulate_pov_time method to utilize traffic lane positions, enhancing POV time tracking.
    - Improved integration of traffic lane data within the Camera class for better navigation accuracy.
2026-06-24 Add PID test script and disable odometry correction
    Run test_pid() from main and comment out the corridor/corner odometry
    corrections while tuning the motors. Retune the y-axis PID gains, raise
    the cruise max speed to 60, and adjust the servo centre and the
    clockwise==-1 parking x target.
    [background.py, main.py, move_coordinates.py, obstacle_challenge.py, servo.py]
2026-06-24 Re-enable odometry correction and obstacle challenge
    Restore the corridor/corner odometry corrections and run the obstacle
    challenge from main again. Make the first camera-alignment x depend on
    the travel direction, drop to 2 laps and simplify the parking approach.
    [background.py, main.py, obstacle_challenge.py]
2026-09-08 Add parking-wall detection and rear-sonar alignment
    Raise the odometry-correction sonar thresholds to 6 cm, add a
    detect_parking_wall mode to move_coordinates() that stops on the side
    sonar, and finish the parking manoeuvre by aligning to the rear wall
    with the rear sonar. Also update the obstacle geometry, restore 3 laps
    and add a 3 s timeout while waiting to exit the lane.
    [background.py, field.py, move_coordinates.py, obstacle_challenge.py, state.py]
2026-09-15 Refactor background control logic and improve movement functions
    - Updated PWM control in CruiseControl to handle reversing scenarios more effectively, ensuring proper acceleration and deceleration limits.
    - Adjusted movement logic in move_coordinates and rotate_angle functions for better responsiveness and accuracy in navigation.
    - Enhanced obstacle_challenge function to streamline movement and rotation based on parking conditions, improving overall maneuverability.
    [background.py, move_coordinates.py, obstacle_challenge.py]
2026-09-15 Update angle tolerance and parking logic in movement functions
    - Increased angle tolerance in rotate_coordinates and rotate_angle functions from 5 to 10 degrees for improved maneuverability.
    - Adjusted parking x offset from 20 to 5 to refine parking position.
    - Reduced lap count in obstacle_challenge from 3 to 1 for streamlined execution.
    - Enhanced parking logic to ensure proper movement and rotation during parking maneuvers, improving overall navigation accuracy.
    [move_coordinates.py, obstacle_challenge.py]
2026-09-15 Rework tight-space parking alignment angles
    Replace the symmetric +/-15 degree parking alignment with explicit angles
    per rotation direction, since the steering limits are not symmetric.
    [obstacle_challenge.py]
2026-09-22 Refine movement logic and speed adjustments in navigation functions
    - Decreased angle tolerance in rotate_coordinates and rotate_angle functions for more precise control.
    - Adjusted target speeds based on angle thresholds to enhance responsiveness during navigation.
    - Increased lap count in obstacle_challenge from 1 to 3 for extended testing.
    - Modified rotation angles in obstacle_challenge to improve maneuverability around obstacles.
    - Reduced sleep duration during obstacle avoidance for quicker response times.
    [move_coordinates.py, obstacle_challenge.py]
2026-09-22 Adjust movement parameters and conditions for improved navigation
    - Increased angle tolerance in rotate_coordinates function for smoother rotation.
    - Modified target speeds in rotate_coordinates to enhance responsiveness.
    - Reduced deceleration distance and minimum speed in move_coordinates for better control.
    - Updated obstacle_challenge logic to conditionally execute movements based on relative odometry, improving obstacle avoidance.
    [move_coordinates.py, obstacle_challenge.py]
2026-10-01 Add sleep delay in obstacle challenge for smoother navigation
    - Introduced a 0.05-second sleep delay in the obstacle_challenge function to enhance responsiveness during movement adjustments.
    - Ensured consistent timing for target speed changes, improving overall obstacle avoidance behavior.
    [obstacle_challenge.py]
2026-10-06 Fix traffic-light camera angle calculation
    Use radians for the camera position offset and re-enable angle-based matching of detected traffic lights.
    [camera.py]
2026-10-06 Migrate to uasyncio, add distance framing, and fix issues
    Replace _thread with uasyncio (single-core cooperative concurrency).
    Add header (0xA5) + XOR checksum framing to the distance UART protocol with re-synchronisation; distance getters now read cached values.
    Fix and/or precedence, zero-length move guard, final-lap camera-x condition, add safety timeouts, real dt for PID, and try/finally motor stop.
    [background.py, distance.py, init.py, main.py, move_coordinates.py, obstacle_challenge.py, open_challenge.py]
2026-10-06 Add SonarSlave firmware with concurrent async sonar measurement
    Measures the four sonars concurrently (uasyncio) and transmits the framed distance protocol (header 0xA5 + XOR checksum) over UART.
2026-10-06 Optimize encoder IRQ handler for speed
    Use module-level globals instead of class-attribute lookups in the interrupt handler, and drop the redundant comparison, to reduce per-pulse work and avoid missed counts.
    [encoder.py]
2026-10-06 Add SonarSlave debug tool
    Standalone script that measures each sonar sequentially and all four concurrently, prints the values side by side (to spot cross-talk), and dumps the exact UART frame (header + checksum) it would send.
2026-10-06 Split background task into independent asyncio tasks
    Replace the single background_task loop with six independent asyncio tasks (sensor, camera, odometry, speed/cruise, telemetry, odometry-adjust), each with its own interval and sleep, started via start_background_tasks().
    [background.py, main.py]
2026-10-06 Revert asyncio migration back to _thread
    The asyncio migration caused driving problems on the robot. Restore the previous _thread-based background task (running on the second core) while keeping the distance framing, cached distance reads, and bug fixes.
    [background.py, init.py, main.py, move_coordinates.py, obstacle_challenge.py, open_challenge.py]
2026-10-06 Add odometry debug tool
    Standalone script that prints gyro heading (and drift) plus encoder distance in a loop, to isolate whether odometry drift comes from the gyro or the encoder.
    [debug_odom.py]
2026-10-06 Reduce camera polling to 50 Hz to lower background load
    Camera.update() was running at 200 Hz and recomputing trigonometry (sqrt/atan2) even without new frames, starving odometry and cruise control on the background core. The OpenMV sends ~30-60 FPS, so poll at 50 Hz instead.
2026-10-06 Only recompute camera POV and reprocess blobs on new frames
    Camera.update() was recomputing get_traffic_lane_inside_pov() and reprocessing the same blobs every call (heavy sqrt/atan2). Now it only does so when a new frame arrives; POV time accumulation still runs every call.
2026-10-06 Add software debounce to encoder IRQ
    The faster IRQ handler was now catching bounce/noise edges on channel A, overcounting and making odometry overestimate distance. Ignore edges closer than DEBOUNCE_US (50 us) apart.
    [encoder.py]
2026-10-06 Lower max_speed to 45 cm/s to avoid motor saturation and slip
    The 500 RPM motor tops out at ~50 cm/s, but move_coordinates targeted 60 cm/s, keeping the motor at full PWM and causing wheel slip (odometry overestimate). Target 45 cm/s instead.
    [move_coordinates.py]
2026-10-06 Increase encoder debounce to 200 us
    50 us did not filter the motor electrical noise causing odometry overcounting. At 500 RPM the encoder period is ~600 us, so 200 us still has 3x margin and filters higher-frequency noise edges.
    [encoder.py]
2026-10-06 Raise motor PWM frequency to 20 kHz
    The 1 kHz PWM switching noise was coupling into the encoder and creating spurious edges (encoder kept counting while the motor was stalled). Moving to 20 kHz puts the switching noise above the encoder band so it is easier to filter.
    [motor.py]
2026-10-14 Prevent cruise control from reversing during forward driving
    The integrator-based cruise control could go negative on overshoot and reverse the motor, making the odometry run backwards. Clamp PWM to non-negative when target_speed >= 0 (and non-positive when < 0) so the motor coasts instead of reversing.
2026-10-14 Use dynamic encoder debounce based on speed
    The fixed 200 us debounce let noise dominate at low speed (sparse real edges). Now the debounce scales with the expected encoder period (1/4 of it), so it is small at high speed and large at low speed.
2026-10-14 Add communication and power wiring diagrams
    Two PNG schematic diagrams: data/communication links (UART, I2C, PWM, GPIO) and power distribution (battery, regulators, motor, servo, controllers).
2026-10-14 Add obstacle challenge state machine flowchart
2026-10-20 Add table of contents; fill motor selection and gyro evaluation data
2026-10-20 Add steering servo selection rationale (SG90 vs Savox)
2026-10-20 Move software flowchart to other/img; keep schemes for electrical schematics only
2026-10-20 Embed diagrams and flowchart in journal; document sonar orientation
2026-10-20 Update state machine flowchart: add corner step and 13th-section parking branch
2026-10-20 Update lane-following description to match flowchart (sections, corner, 13th-section parking)
2026-10-20 Fix flowchart: rename 13th-section diamond and move title/note clear of the entry arrow
2026-10-20 Revert flowchart to previous version (13th section, original title position)
2026-10-20 Revert flowchart to original version (undo today's corner/13th-section changes)
2026-10-20 Fill power budget with component currents and runtime estimate
2026-10-20 Align iteration history to git; document L7805CV servo-rail heat; add compliance and measurement checklist
2026-10-20 Translate code comments, prints and identifiers to English
2026-10-20 Add bearing specifications to mechanical design
2026-10-20 Revert debug/test code: restore obstacle_challenge and remove print
2026-10-20 Add measurement scripts for test metrics (sonar loss, PID step, odometry drift)
2026-10-20 Add encoder noise isolation test (fixed PWM, no control loop)
2026-10-20 Add control-loop trace to isolate backward odometry bug
2026-10-20 Fix control-loop trace: run drive on main core (no second thread)
2026-10-20 Raise diagnostic speed to 45 cm/s to match move_coordinates
2026-10-27 Fix catastrophic dynamic-debounce feedback loop
    The dynamic debounce set _debounce_us=1500 us when the measured speed dropped below 0.5 cm/s. At that value the real encoder edges (~600 us at 45 cm/s, ~300 us at full speed) were all rejected, so the encoder stopped counting and the speed stayed at 0 -> the debounce stayed at 1500 us forever. Replaced with a fixed 200 us debounce that filters the 20 kHz PWM noise (~50 us) while keeping the real edges.
2026-10-27 Simplify: remove encoder debounce, simple CruiseControl, remove Motor.stop side effect
    Also keep the inverted motor/encoder direction required by the replacement motor, and remove the state.target_speed=0 side effect from Motor.stop().
2026-10-27 Faster deceleration: higher decel rate + active braking
    max_decel raised from 2/3 to 2.0 per second, and when the controller wants to slow past zero (overshoot) the motor is shorted (brake mode) instead of coasting.
2026-10-27 Replace hard brake with reverse-torque braking (no stop-start)
    The short brake stopped the robot completely at ~195 cm, then static friction required extra torque to restart. Negative PWM now drives the motor backwards (reverse torque) so it decelerates without a full stop.
2026-10-27 Add minimum drive PWM to stop the motor stalling near the target
    Below ~0.13 PWM static friction stops the N20 motor, so the robot stalled 4 cm short of the target and needed a restart. When the target speed is positive the PWM now floors at 0.15.
2026-10-27 Brake when the target speed is zero (stop precisely at the target)
    The N20 motor cannot creep below ~10 cm/s, so the robot reached the target at ~9.8 cm/s and coasted past it. When target_speed is 0 the controller now short-brakes the motor so the robot stops at the target.
2026-10-27 Smooth low-speed control: lower kp and low-pass filter the speed
    At target 15 cm/s the kp=1/70 controller chased encoder noise/cogging and oscillated 12-21 cm/s. kp is halved to 1/150 and current_speed is now an EMA of the raw speed.
2026-10-27 Set realistic minimum speed (12 cm/s) in the deceleration profile
    The motor cannot creep below ~10-13 cm/s (static friction vs the 0.15 PWM floor), so a min_speed of 5 made the robot fight the floor and oscillate near the target. min_speed is now 12, which the motor can actually hold.
2026-10-27 Add brake anticipation so the robot stops at the target
    The loop used to set target_speed=0 only after the robot had already passed the target, so it stopped one braking distance late. It now brakes when remaining <= v^2/(2a), with a=300 cm/s^2.
2026-10-27 Use raw speed for brake anticipation and calibrate BRAKE_DECEL
    The filtered current_speed lags the real speed, so the braking distance was underestimated and the robot overshot 1.3 cm. The stop now uses state.raw_speed, and BRAKE_DECEL was measured at ~150-165 cm/s^2.
2026-10-27 Calibrate BRAKE_DECEL to the measured ~144 cm/s^2 (use 120 for margin)
2026-10-27 Revert brake anticipation (triggered too early)
    state.raw_speed lags by up to 100 ms (the SPEED_INTERVAL_MS window), so during deceleration it overestimated the braking distance (24 cm at 22 cm remaining) and braked the robot mid-run. Back to braking only when target_speed reaches 0, which already stopped at ~199.9 cm.
2026-10-27 Add brake-distance measurement script
2026-10-27 Brake anticipation from measured braking distance
    Measured s(v) at 19/32/42/61/77 cm/s = 2.10/2.61/5.34/4.25/7.04 cm. The distance is roughly linear (s = 1.0 + 0.08*v) because it includes the ~50-100 ms cruise-control delay. The robot now brakes when remaining <= s(v).
2026-10-27 Stop before reversing to prevent wheel slip / odometry loss
    Reversing while the robot still rolls forward makes the wheels skid: the encoder counts wheel spin that does not translate into travel, so the odometry drifts. rotate_coordinates and rotate_angle now bring the robot to a stop (and settle 100 ms) before reversing.
2026-10-27 Revert "Stop before reversing to prevent wheel slip / odometry loss"
    This reverts commit b5c93358f4dd0d4e3be9395e9d4d313553a7602c.
2026-10-27 Add direction-change guard to prevent wheel slip
    When the target and current motion have opposite signs, brake to a full stop before accelerating in the new direction. This covers both forward->reverse and reverse->forward, which otherwise skid the wheels and corrupt the odometry.
2026-10-27 Apply min-drive floor before the rate limit (smooth start)
    The floor was applied to current_pwm after the rate limit, so starting from 0 jumped straight to 0.15 (~12 cm/s) in one cycle. That abrupt start skidded the wheels when turning. The floor now shapes desired_pwm, so max_accel still ramps the PWM.
2026-10-27 Scale accel/decel with steering angle to avoid skidding in turns
    The cruise control now reads Servo.current_angle and scales max_accel/max_decel from 1.0 (straight) down to 0.5 (fully steered, 29 deg), so sharp turns get half the torque and do not scrub the wheels.
2026-10-27 Raise fully-steered accel scale from 0.5 to 0.65
2026-10-27 Fast ramp to the friction floor when starting from rest
    After the floor was moved before the rate limit, the PWM took ~0.5 s to reach the 0.15 static-friction floor, during which the robot did not move (a stall at every move/rotate). Starting from rest now ramps 4x faster up to the floor, then uses the normal steering-scaled rate.
2026-10-27 TEMP: log control timeline (target/speed/pwm/steering) to find the stop
2026-10-27 TEMP: send control timeline via Telemetry.log instead of print
2026-10-27 Extend start kick to 0.30 PWM (past the creep region)
    Telemetry showed the robot creeping at 5-15 cm/s for ~0.5 s at every routine start: the PWM had to ramp from 0.15 to ~0.30 at the normal rate. The start kick now covers up to 0.30, so the creep zone is crossed in ~0.2 s.
2026-10-27 Do not block waiting for the robot to stop at each waypoint
    Telemetry showed target_speed=0 ~15% of the run: move_coordinates waited for |raw_speed|<1 before returning, adding 0.5-1 s per transition (40+ per lap). It now brakes and returns immediately; the next routine takes over while the cruise control finishes the stop.
2026-10-27 Lane search: one continuous move that stops when the colour is seen
    move_coordinates gained a stop_when callback, checked every loop iteration. The lane search uses it to drive forward until the camera detects the lane opening, replacing the 10 cm hops that stopped between each step.
2026-10-27 Faster direction change (raw speed) and remove temp DIAG
    The direction guard used the filtered current_speed, which decays over ~500 ms, so every reversal waited that long. It now uses state.raw_speed with a 3 cm/s threshold, releasing in ~150-250 ms. The temporary DIAG telemetry is removed.
2026-10-27 Hold the reversal brake for a fixed 500 ms
    Replaces the speed-based guard (whose hold time drifted with the filtered/raw speed) with a fixed REVERSE_HOLD_MS=500 window, so every forward<->reverse change waits the same 500 ms before reversing.
2026-11-03 Update odometry handling and adjust speed limits
    - Changed ADJUST_ODOM_INTERVAL_MS from 200 to 25 for improved responsiveness.
    - Introduced update_odom function to streamline odometry updates and added checks for offsets.
    - Enhanced corner and corridor correction logic to improve navigation accuracy.
    - Adjusted max_speed in move_coordinates from 70 to 50 to prevent motor saturation.
    - Modified target_in_rotation_area radius from 30 to 35 for better detection.
2026-11-11 Align journal cruise-control constants with current code
2026-11-11 Record vehicle mass (610 g) and update overall length to 200 mm
2026-11-11 Add 3D CAD files (STEP) to models/ with English names
2026-11-11 Add STL versions of the 3D models
2026-11-11 Add axle photos and suspension animation to the journal
2026-11-11 Clarify the suspension is front-axle only
2026-11-11 Add front and rear axle images to the project
2026-11-11 Document the Extended Kalman filter in README and journal
2026-11-11 Add drivetrain and chassis design parameters to the journal
2026-11-11 Remove the 102 mm wheel-footprint parameter
2026-11-11 Add Onshape CAD link and robot profile PDF
2026-11-11 Replace camera firmware with the sign localiser (x,y,h in cm)
2026-11-11 Parse new camera format and implement the Surprise Rule (invert colour on 5/15 cm signs)
2026-11-11 Camera reads colour as-is; the firmware/scoring invert from the height
2026-11-11 Match camera signs to field positions by coordinates (5 cm radius)
2026-11-11 Fix camera offset to 10.5 cm and deduplicate the camera-pose computation
2026-11-11 Debug camera: show obstacle coordinates relative to the robot
2026-11-11 Fix debug robot frame: x is forward, y is lateral
2026-11-11 Fix camera pose and sign transform for heading 0 = +x (cos, sin)
2026-11-11 Debug camera: track the robot from encoder + IMU so fixed signs stay put
2026-11-11 Debug camera: drive the pose from the EKF instead of raw integration
2026-11-11 Address rubric gaps: sonar concurrency, camera placement/calibration, CAM format, version/SHA, commit count
2026-11-11 Add material/stiffness rationale, nose length 73 mm, honest servo note
2026-11-11 Stamp journal with the current HEAD SHA
